aikopras/SafetyDecoder/extras/1-safety-local.pdf

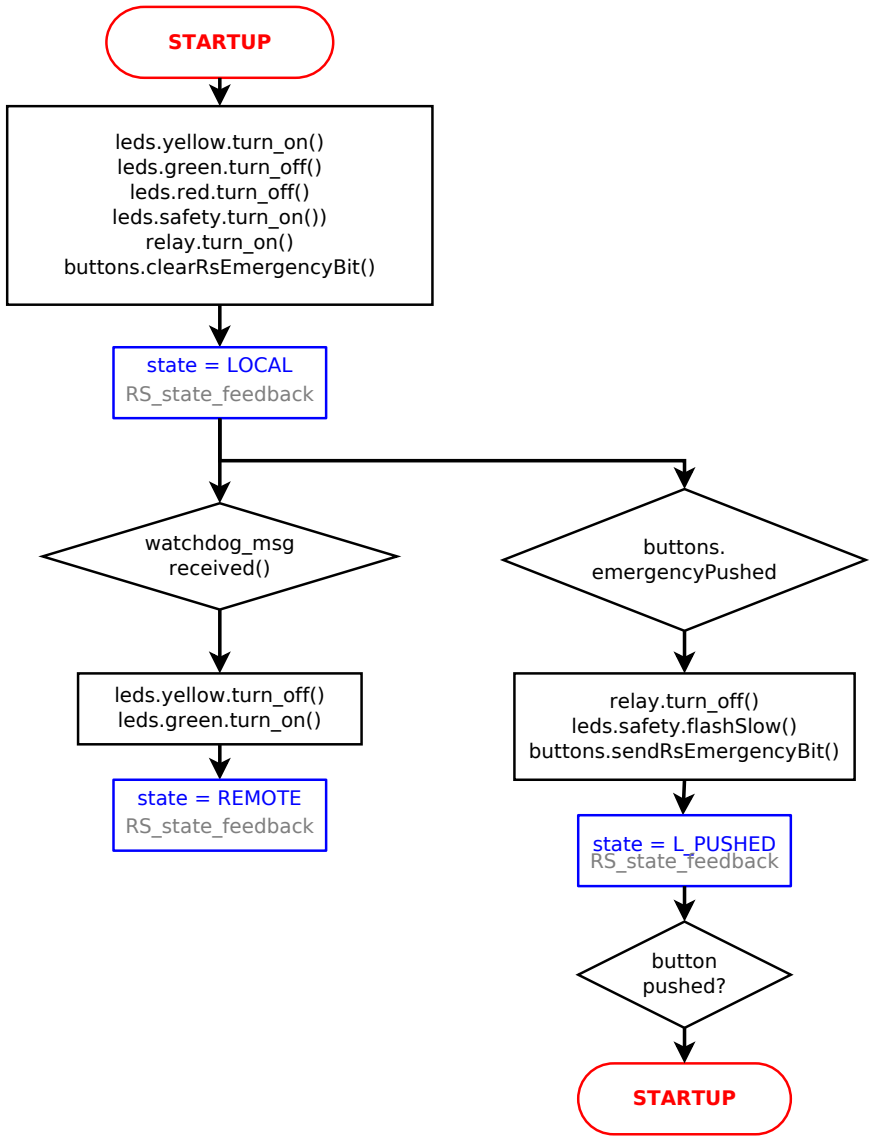
[picture p3: figure]
STARTUP; buttons. emergencyPushed; button pushed?; state = L_PUSHED RS_state_feedback; leds.yellow.turn_on() leds.green.turn_off() leds.red.turn_off() leds.safety.turn_on()) relay.turn_on() buttons.clearRsEmergencyBit(); watchdog_msg received(); leds.yellow.turn_off() leds.green.turn_on(); state = LOCAL RS_state_feedback; state = REMOTE RS_state_feedback; relay.turn_off() leds.safety.flashSlow() buttons.sendRsEmergencyBit()

state: LOCAL | 1
REMOTE | 2
L_PUSHED | 3
R_RELAY_OFF | 4

RSBus state feedback bits

RSBus:

state buttons

Default emergency button
Can be changed via CVs

STARTUP

resetMsg
Received()?

state != STARUP
&&
state != LOCAL

The HALT button on the handheld or the "Einfrieren" command on TrainController is pushed
