aikopras/SafetyDecoder/extras/2-safety-remote.pdf

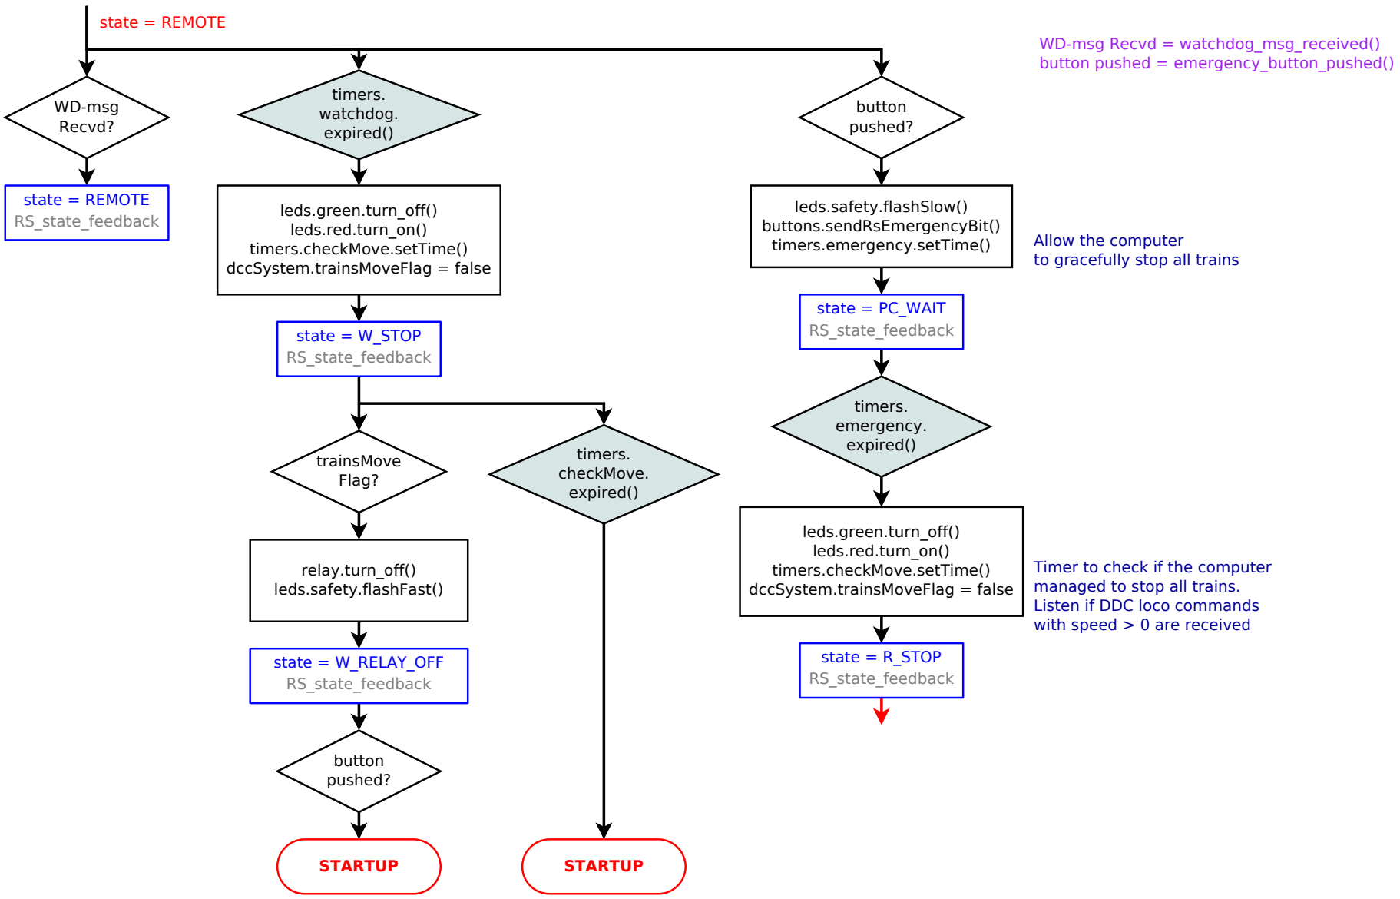
[picture p4: figure]
WD-msg Recvd?; state = REMOTE; timers. watchdog. expired(); button pushed?; relay.turn_off() leds.safety.flashFast(); trainsMove Flag?; STARTUP; WD-msg Recvd = watchdog_msg_received() button pushed = emergency_button_pushed(); leds.safety.flashSlow() buttons.sendRsEmergencyBit() timers.emergency.setTime(); state = W_RELAY_OFF RS_state_feedback; RS_state_feedback; leds.green.turn_off() leds.red.turn_on(); timers.checkMove.setTime() dccSystem.trainsMoveFlag = false; timers. checkMove. expired(); state = W_STOP RS_state_feedback; Allow the computer to gracefully stop all trains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
