aikopras/SafetyDecoder/extras/3-safety-remote-button.pdf

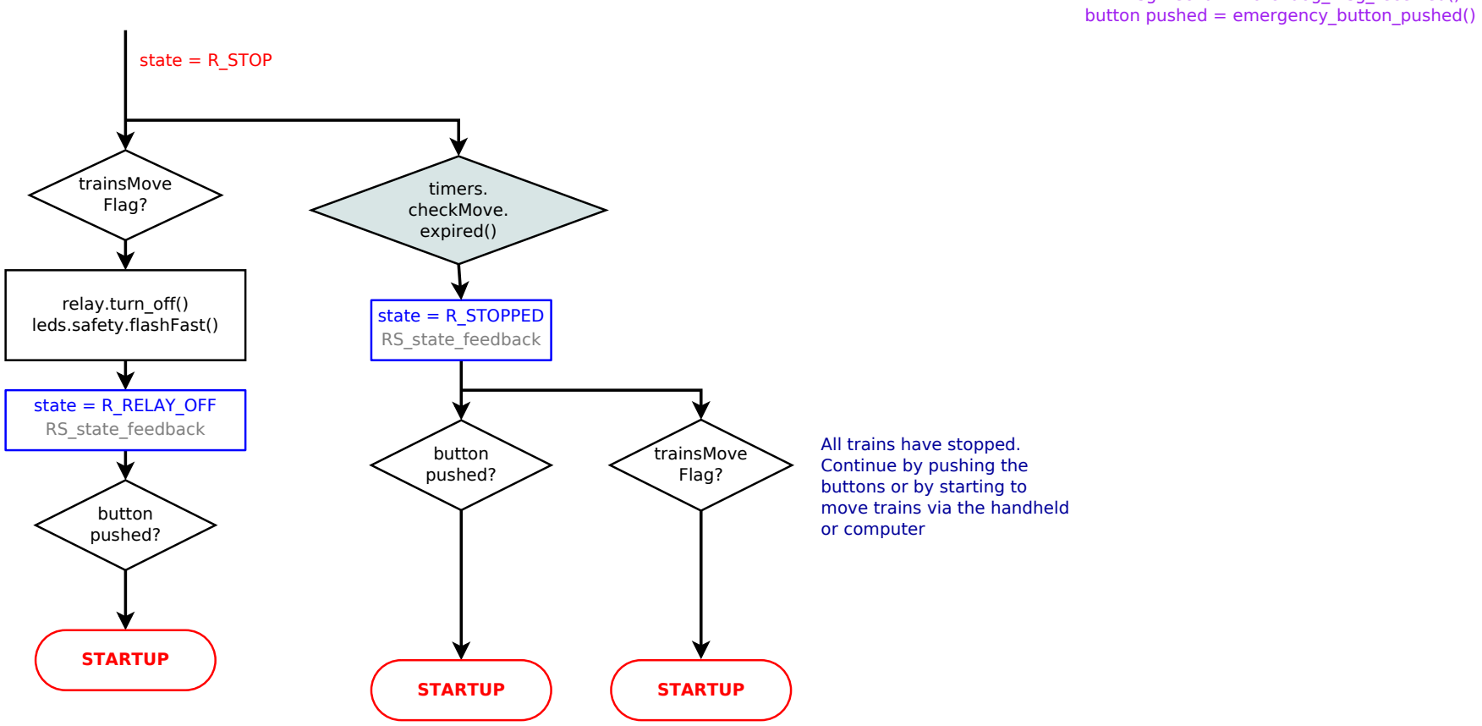
[picture p5: figure]
state = R_STOP; button pushed?; trainsMove Flag?; STARTUP; button pushed = emergency_button_pushed(); relay.turn_off(); leds.safety.flashFast(); state = R_STOPPED RS_state_feedback; state = R_RELAY_OFF RS_state_feedback; timers. checkMove. expired(); All trains have stopped. Continue by pushing the buttons or by starting to move trains via the handheld or computer

WD-msg Recvd = watchdog_msg_received()
