aikopras/SafetyDecoder/extras/PCB.pdf

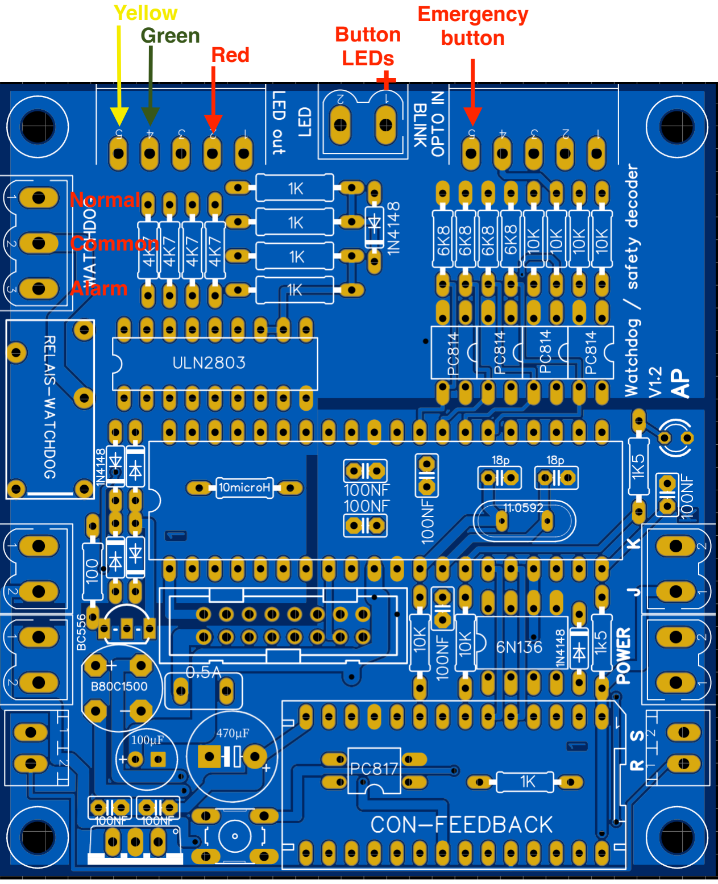
[picture p6: page 1]
