aikopras/SafetyDecoder/(commit log)

2020-07-26 Initial upload
    [ADR-PORT.xlsx]
2020-10-05 Can now be compiled using the Arduino IDE
    An .ino file has been added, to allow compilation and flashing using the Arduino IDE. The main program has been extended to include a check if the EEPROM has been initialised. If not, the default CV values will be set in EEPROM.
    Note that also "doProgramming()" has been uncommented, and the software version increased to 0x10. Although the safety decoder is working, additional tests and some cleaning up of the code may be necessary.
2022-07-31 Complete rewrite
    The code has been completely rewritten and is now 100% Arduino C++ code
    [ADR-PORT.xlsx]
2022-08-02 References adjusted
    Reference to AP_DCC_Decoder_Basic.h replaced by AP_DCC_Decoder_Core.h
    [SafetyDecoder.ino, button.cpp, dcc.cpp, dcc_rs.h, safety.cpp]
